HexabitzPlatform/H16R6x/README.md

# H16R6x-Hardware
Hexabitz 8*8 RGB LED Matrix Display Module Hardware Design
