HexabitzPlatform/H16R6x/Released/BOM/H16R6.xlsx

 |  | www.hexabitz.com info@hexabitz.com |  | Bill Of Materials
Customer | Hexabitz | Revision | 0
Project | Hexabitz Modules | Date | 2024-02-10
Board | Matrix LED Display Module (H16R6) | Notes
Designator | Description | Manufacturer Part Number | Manufacturer | Octopart Url | Quantity
R | PCB Header, Unshrouded, Thru 02 Straight Header, .101, AMPMODU Mod II Series | 5-146280-1 | TE Connectivity | https://octopart.com/5-146280-1-te+connectivity+%2F+amp-40259676?r=sp (https://octopart.com/87227-1-te+connectivity-39512052?r=sp) | 1
SWD | Conn Unshrouded Header HDR 3 POS 2.54mm Solder ST Top Entry Thru-Hole Carton | 5-146281-3 | TE Connectivity | https://octopart.com/5-146281-3-te+connectivity+%2F+amp-39745942?r=sp | 1
PWR_IN, PWR_OUT, SERIAL_IN, SERIAL_OUT | 2 Position Total Single Row 2.54 mm Pitch Straight Male Thru-Hole Header | M20-9990245 | HARWIN INC | https://octopart.com/m20-9990245-harwin-7492269?r=sp | 4
C3, C5, C6, C8, C10, C11, C12, C13, C14, C15, C17, C18, C19, C21, C22, C30, C31, C32 | CAP 0402 0,1UF 16V TDK Multilayer Ceramic Capacitors MLCC-SMD/SMT | CGA2B1X7R1C104K050BC | TDK | https://octopart.com/cga2b1x7r1c104k050bc-tdk-26014376?r=sp (https://octopart.com/c0603c104k8ractu-kemet-145075?r=sp&s=9bS9ASSwSEqMCE9KBEQZ0g) | 18
C2 | CAP CER 1UF 10V X5R 0402 | C0402C105K8PAC7411 | KEMET | https://octopart.com/c0402c105k8pac7411-kemet-75146233?r=sp | 1
C7, C4, C9, C16, C20, C23, C24, C25, C26, C27 | Multilayer Ceramic Capacitors MLCC - SMD/SMT 0603 25V 4.7uF X5R 10% T: 0.8mm | C1608X5R1E475K080AC | TDK | https://octopart.com/c1608x5r1e475k080ac-tdk-26013502?r=sp | 10
R2, R4, R5 | RES SMD 0 OHM JUMPER 1/16W 0402 | AC0402JR-070RL | YAGEO | https://octopart.com/ac0402jr-070rl-yageo-21711084?r=sp (https://octopart.com/rc0603jr-070rl-yageo-1241539?r=sp) | 3
R1 | Thick Film Resistors - SMD 0402 1%270ohm | ERJ-PA2F2700X | Panasonic | https://octopart.com/search?q=ERJ-PA2F2700X&currency=USD&specs=0 (https://octopart.com/erj-3geyj271v-panasonic-55560546) | 1
R3 | RES 10K OHM 1% Yageo Thick Film Resistors -SMD 1/16W 0402 | RC0402FR-0710KL | YAGEO | https://octopart.com/rc0402fr-0710kl-yageo-55458461?r=sp (https://octopart.com/search?q=RC0603FR-0710KL&currency=USD&specs=0) | 3
FB1 | Ind chip Bead Multi-Layer 30 ohms 25% 100MHZ Ferrite 1,5A 0603Punched paper T/R | MMZ1608Y300BTA00 | TDK | https://octopart.com/mmz1608y300bta00-tdk-7906990?r=sp | 1
D1 | Red 0603 130° Clear 54 mcd 2 V Surface Mount ChipLED | VLMS1300-GS08 | Vishay (https://octopart.com/manufacturers/wolfspeed) | https://octopart.com/vlms1300-gs08-vishay-21709201?r=sp&s=_gcP4_q8T1SC6PJQPTQ9yA | 1
D2, D3, D4, D5, D6, D7, D8, D9, D10, D11, D12, D13, D14, D15, D16, D17, D18, D19, D20, D21, D22, D23, D24, D25, D26, D27, D28, D29, D30, D31, D32, D33, D34, D35, D36, D37, D38, D39, D40, D41, D42, D43, D44, D45, D46, D47, D48, D49, D50, D51, D52, D53, D54, D55, D56, D57, D58, D59, D60, D61, D62, D63, D64, D65 | SMD LED - RGB APA102-2020 (Pack of 10) | APA102-2020 | SparkFun | https://octopart.com/com-14608-sparkfun-89779982?r=sp | 64
D66 | TVS DIODE 3,3V 10,9V SOD323 | CDSOD323-T03SC | BOURNS INC | https://octopart.com/cdsod323-t03sc-bourns-10487153?r=sp | 1
U1 | MCU 32-Bit ARM Cortex-M0+ RISC 512kByte Flash 1.7V to 3.6V 48-Pin UFQFPN Tray | STM32G0B1CEU6N | STMicroelectronics | https://octopart.com/stm32g0b1ceu6n-stmicroelectronics-116364672?r=sp | 1
IC1 | Voltage Level Translator 2-CH Bidirectional 8-Pin X2-DFN T/R | 74LVC2T45HK3-7 | Diodes Inc. | https://octopart.com/74lvc2t45hk3-7-diodes+inc.-116237008?r=sp | 1
X1 | 8,0000MHZ 33pF SMD MURATA Resonators | CSTNE8M00G550000R0 | Murata | https://octopart.com/cstne8m00g550000r0-murata-91406934?r=sp | 1
