HexabitzPlatform/H16R6x/Design/H16R6.brd

## EAGLE design Design/H16R6.brd (2024-04-26)

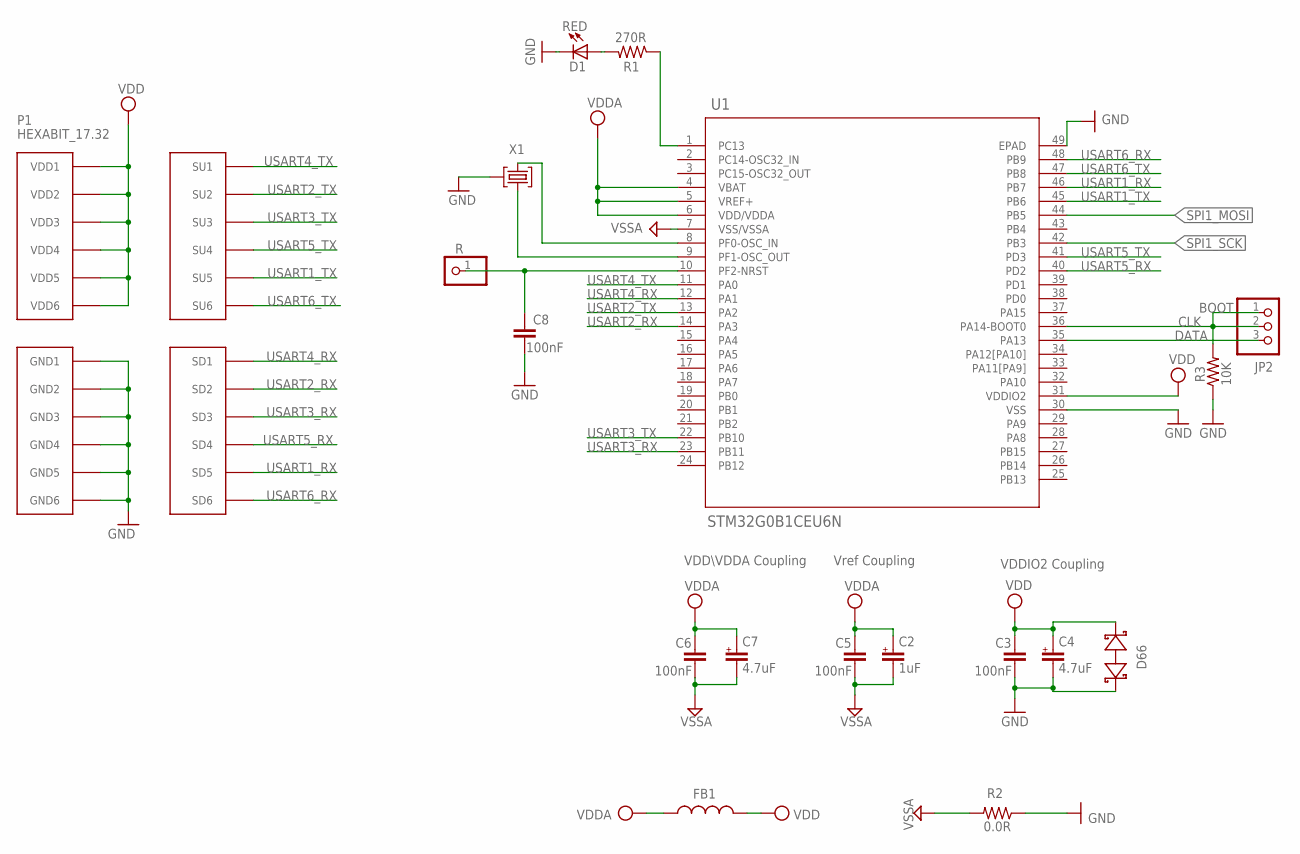
[picture p4: schematic H16R6.sch, sheet 1]

Parts:
C2: 1uF; C-0402-POL
C3, C5, C6, C8: 100nF; C-0402
C4, C7: 4.7uF; C-0402-POL
D1: RED; VLMS1300-GS08; MPN VLMS1300-GS08
D66: BOURNS_CDSOD323-T03SCBOURNS_CDSOD323-T03SC_0_0; BOURNS_CDSOD323-T03SC_0
FB1: FB-TDK_MMZ1608Y300B; MPN MMZ1608Y300B
JP2: PINHD-1X3; 1X03
P1: HEXABIT_17.32
R: R; 1X01
R1: 270R; R-0402
R2: 0.0R; R-0402; MPN RC0603JR-070RL
R3: 10K; R-0402
TRIMBLE-LOGO1: HEXA-LOGO
U1: STM32G0B1CEU6N; HEXABITZ_ICS_QFN_B1CEU6_STM-L
X1: XTALL_CSTCE8M00G52

Connections:
CLK: JP2.1, JP2.2, R3.2, U1.36 (PA14-BOOT0)
DATA: JP2.3, U1.35 (PA13)
GND: C3.2, C4.2, C8.2, D1.C, D66.1 (A), P1.PAD_PD7 (GND1), P1.PAD_PD8 (GND2), P1.PAD_PD9 (GND3), P1.PAD_PD10 (GND4), P1.PAD_PD11 (GND5), P1.PAD_PD12 (GND6), R2.1, R3.1, U1.30 (VSS), U1.49 (EPAD), X1.P$2 (2); also elsewhere on the board
unnamed: D1.A, R1.2
unnamed: C8.1, R.1, U1.10 (PF2-NRST)
unnamed: U1.9 (PF1-OSC_OUT), X1.P$1 (1)
unnamed: U1.8 (PF0-OSC_IN), X1.P$3 (3)
unnamed: R1.1, U1.1 (PC13)
SPI1_MOSI: U1.44 (PB5); also elsewhere on the board
SPI1_SCK: U1.42 (PB3); also elsewhere on the board
USART1_RX: P1.PAD_PD5 (SD5), U1.46 (PB7)
USART1_TX: P1.PAD_PU5 (SU5), U1.45 (PB6)
USART2_RX: P1.PAD_PD2 (SD2), U1.14 (PA3)
USART2_TX: P1.PAD_PU2 (SU2), U1.13 (PA2)
USART3_RX: P1.PAD_PD3 (SD3), U1.23 (PB11)
USART3_TX: P1.PAD_PU3 (SU3), U1.22 (PB10)
USART4_RX: P1.PAD_PD1 (SD1), U1.12 (PA1)
USART4_TX: P1.PAD_PU1 (SU1), U1.11 (PA0)
USART5_RX: P1.PAD_PD4 (SD4), U1.40 (PD2)
USART5_TX: P1.PAD_PU4 (SU4), U1.41 (PD3)
USART6_RX: P1.PAD_PD6 (SD6), U1.48 (PB9)
USART6_TX: P1.PAD_PU6 (SU6), U1.47 (PB8)
VDD: C3.1, C4.1, D66.2 (C), FB1.2, P1.PAD_PU7 (VDD1), P1.PAD_PU8 (VDD2), P1.PAD_PU9 (VDD3), P1.PAD_PU10 (VDD4), P1.PAD_PU11 (VDD5), P1.PAD_PU12 (VDD6), U1.31 (VDDIO2); also elsewhere on the board
VDDA: C2.1, C5.1, C6.1, C7.1, FB1.1, U1.4 (VBAT), U1.5 (VREF+), U1.6 (VDD/VDDA)
VSSA: C2.2, C5.2, C6.2, C7.2, R2.2, U1.7 (VSS/VSSA)

Notes on the sheet:
Vref Coupling
VDDIO2 Coupling
VDD\VDDA Coupling
BOOT

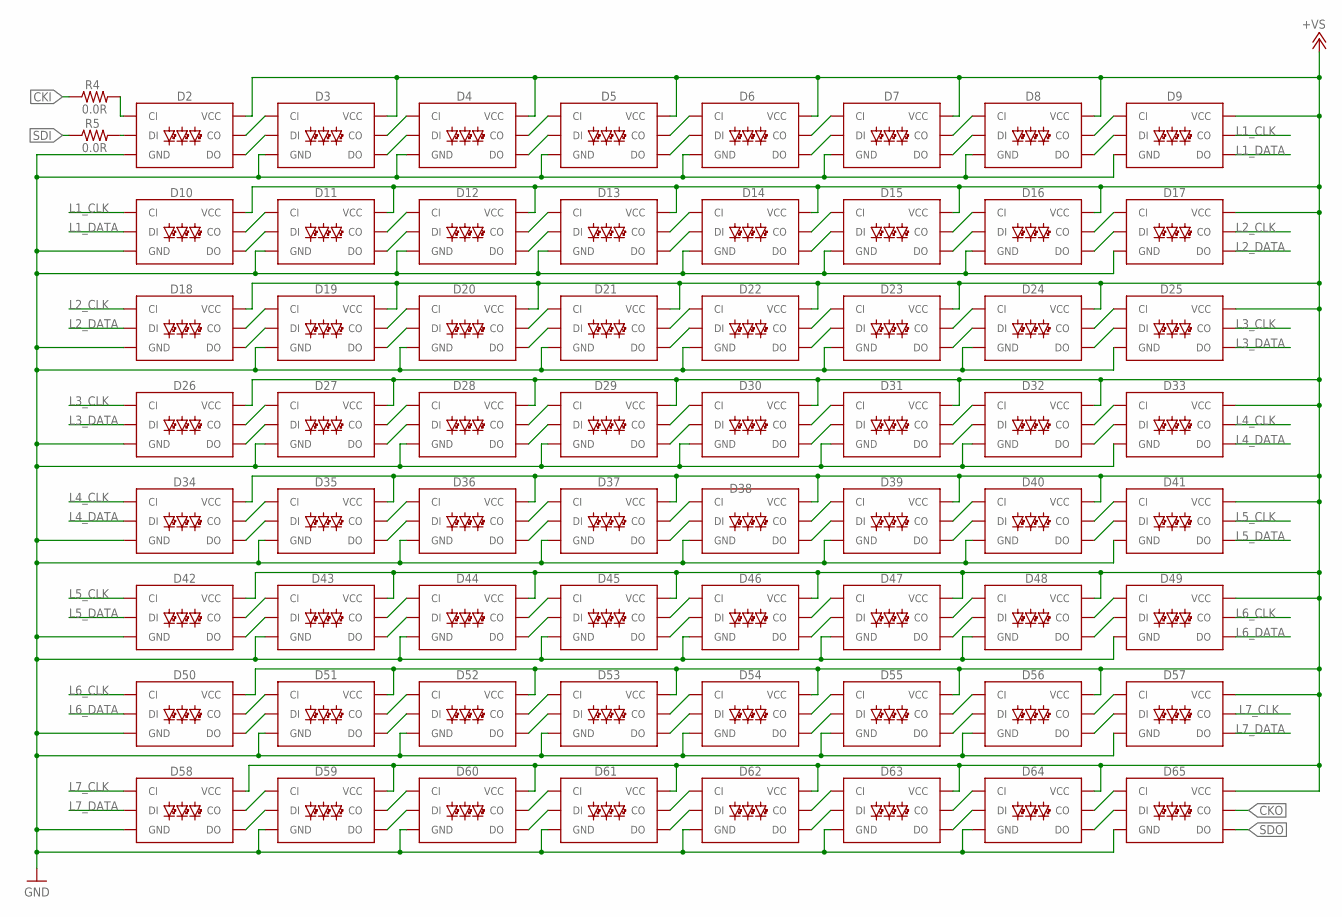
[picture p5: schematic H16R6.sch, sheet 2]

Parts:
D2, D3, D4, D5, D6, D7, D8, D9, D10, D11, D12, D13, D14, D15, D16, D17, D18, D19, D20, D21, D22, D23, D24, D25, D26, D27, D28, D29, D30, D31, D32, D33, D34, D35, D36, D37, D38, D39, D40, D41, D42, D43, D44, D45, D46, D47, D48, D49, D50, D51, D52, D53, D54, D55, D56, D57, D58, D59, D60, D61, D62, D63, D64, D65: SPARKFUN-LED_APA102-2020
R4, R5: 0.0R; R-0402

Connections:
+VS: D2.VDD (VCC), D2.VDD1 (VCC), D3.VDD (VCC), D3.VDD1 (VCC), D4.VDD (VCC), D4.VDD1 (VCC), D5.VDD (VCC), D5.VDD1 (VCC), D6.VDD (VCC), D6.VDD1 (VCC), D7.VDD (VCC), D7.VDD1 (VCC), D8.VDD (VCC), D8.VDD1 (VCC), D9.VDD (VCC), D9.VDD1 (VCC), D10.VDD (VCC), D10.VDD1 (VCC), D11.VDD (VCC), D11.VDD1 (VCC), D12.VDD (VCC), D12.VDD1 (VCC), D13.VDD (VCC), D13.VDD1 (VCC), D14.VDD (VCC), D14.VDD1 (VCC), D15.VDD (VCC), D15.VDD1 (VCC), D16.VDD (VCC), D16.VDD1 (VCC), D17.VDD (VCC), D17.VDD1 (VCC), D18.VDD (VCC), D18.VDD1 (VCC), D19.VDD (VCC), D19.VDD1 (VCC), D20.VDD (VCC), D20.VDD1 (VCC), D21.VDD (VCC), D21.VDD1 (VCC), D22.VDD (VCC), D22.VDD1 (VCC), D23.VDD (VCC), D23.VDD1 (VCC), D24.VDD (VCC), D24.VDD1 (VCC), D25.VDD (VCC), D25.VDD1 (VCC), D26.VDD (VCC), D26.VDD1 (VCC), D27.VDD (VCC), D27.VDD1 (VCC), D28.VDD (VCC), D28.VDD1 (VCC), D29.VDD (VCC), D29.VDD1 (VCC), D30.VDD (VCC), D30.VDD1 (VCC), D31.VDD (VCC), D31.VDD1 (VCC), D32.VDD (VCC), D32.VDD1 (VCC), D33.VDD (VCC), D33.VDD1 (VCC), D34.VDD (VCC), D34.VDD1 (VCC), D35.VDD (VCC), D35.VDD1 (VCC), D36.VDD (VCC), D36.VDD1 (VCC), D37.VDD (VCC), D37.VDD1 (VCC), D38.VDD (VCC), D38.VDD1 (VCC), D39.VDD (VCC), D39.VDD1 (VCC), D40.VDD (VCC), D40.VDD1 (VCC), D41.VDD (VCC), D41.VDD1 (VCC), D42.VDD (VCC), D42.VDD1 (VCC), D43.VDD (VCC), D43.VDD1 (VCC), D44.VDD (VCC), D44.VDD1 (VCC), D45.VDD (VCC), D45.VDD1 (VCC), D46.VDD (VCC), D46.VDD1 (VCC), D47.VDD (VCC), D47.VDD1 (VCC), D48.VDD (VCC), D48.VDD1 (VCC), D49.VDD (VCC), D49.VDD1 (VCC), D50.VDD (VCC), D50.VDD1 (VCC), D51.VDD (VCC), D51.VDD1 (VCC), D52.VDD (VCC), D52.VDD1 (VCC), D53.VDD (VCC), D53.VDD1 (VCC), D54.VDD (VCC), D54.VDD1 (VCC), D55.VDD (VCC), D55.VDD1 (VCC), D56.VDD (VCC), D56.VDD1 (VCC), D57.VDD (VCC), D57.VDD1 (VCC), D58.VDD (VCC), D58.VDD1 (VCC), D59.VDD (VCC), D59.VDD1 (VCC), D60.VDD (VCC), D60.VDD1 (VCC), D61.VDD (VCC), D61.VDD1 (VCC), D62.VDD (VCC), D62.VDD1 (VCC), D63.VDD (VCC), D63.VDD1 (VCC), D64.VDD (VCC), D64.VDD1 (VCC), D65.VDD (VCC), D65.VDD1 (VCC); also elsewhere on the board
CKI: R4.1; also elsewhere on the board
CKO: D65.CO; also elsewhere on the board
GND: D2.GND, D3.GND, D4.GND, D5.GND, D6.GND, D7.GND, D8.GND, D9.GND, D10.GND, D11.GND, D12.GND, D13.GND, D14.GND, D15.GND, D16.GND, D17.GND, D18.GND, D19.GND, D20.GND, D21.GND, D22.GND, D23.GND, D24.GND, D25.GND, D26.GND, D27.GND, D28.GND, D29.GND, D30.GND, D31.GND, D32.GND, D33.GND, D34.GND, D35.GND, D36.GND, D37.GND, D38.GND, D39.GND, D40.GND, D41.GND, D42.GND, D43.GND, D44.GND, D45.GND, D46.GND, D47.GND, D48.GND, D49.GND, D50.GND, D51.GND, D52.GND, D53.GND, D54.GND, D55.GND, D56.GND, D57.GND, D58.GND, D59.GND, D60.GND, D61.GND, D62.GND, D63.GND, D64.GND, D65.GND; also elsewhere on the board
L1_CLK: D9.CO, D10.CI
L1_DATA: D9.DO, D10.DI
L2_CLK: D17.CO, D18.CI
L2_DATA: D17.DO, D18.DI
L3_CLK: D25.CO, D26.CI
L3_DATA: D25.DO, D26.DI
L4_CLK: D33.CO, D34.CI
L4_DATA: D33.DO, D34.DI
L5_CLK: D41.CO, D42.CI
L5_DATA: D41.DO, D42.DI
L6_CLK: D49.CO, D50.CI
L6_DATA: D49.DO, D50.DI
L7_CLK: D57.CO, D58.CI
L7_DATA: D57.DO, D58.DI
unnamed: D3.DO, D4.DI
unnamed: D3.CO, D4.CI
unnamed: D2.DO, D3.DI
unnamed: D2.CO, D3.CI
unnamed: D8.DO, D9.DI
unnamed: D8.CO, D9.CI
unnamed: D7.CO, D8.CI
unnamed: D7.DO, D8.DI
unnamed: D5.CO, D6.CI
unnamed: D5.DO, D6.DI
unnamed: D16.CO, D17.CI
unnamed: D16.DO, D17.DI
unnamed: D10.CO, D11.CI
unnamed: D10.DO, D11.DI
unnamed: D11.CO, D12.CI
unnamed: D11.DO, D12.DI
unnamed: D12.CO, D13.CI
unnamed: D18.CO, D19.CI
unnamed: D18.DO, D19.DI
unnamed: D19.CO, D20.CI
unnamed: D19.DO, D20.DI
unnamed: D20.CO, D21.CI
unnamed: D20.DO, D21.DI
unnamed: D21.CO, D22.CI
unnamed: D21.DO, D22.DI
unnamed: D22.CO, D23.CI
unnamed: D22.DO, D23.DI
unnamed: D23.CO, D24.CI
unnamed: D23.DO, D24.DI
unnamed: D24.CO, D25.CI
unnamed: D24.DO, D25.DI
unnamed: D26.CO, D27.CI
unnamed: D26.DO, D27.DI
unnamed: D27.CO, D28.CI
unnamed: D27.DO, D28.DI
unnamed: D28.CO, D29.CI
unnamed: D28.DO, D29.DI
unnamed: D29.CO, D30.CI
unnamed: D29.DO, D30.DI
unnamed: D31.CO, D32.CI
unnamed: D31.DO, D32.DI
unnamed: D30.CO, D31.CI
unnamed: D30.DO, D31.DI
unnamed: D32.CO, D33.CI
unnamed: D32.DO, D33.DI
unnamed: D34.CO, D35.CI
unnamed: D34.DO, D35.DI
unnamed: D35.CO, D36.CI
unnamed: D35.DO, D36.DI
unnamed: D36.CO, D37.CI
unnamed: D36.DO, D37.DI
unnamed: D37.CO, D38.CI
unnamed: D37.DO, D38.DI
unnamed: D38.CO, D39.CI
unnamed: D38.DO, D39.DI
unnamed: D40.CO, D41.CI
unnamed: D40.DO, D41.DI
unnamed: D39.CO, D40.CI
unnamed: D39.DO, D40.DI
unnamed: D48.CO, D49.CI
unnamed: D48.DO, D49.DI
unnamed: D56.CO, D57.CI
unnamed: D56.DO, D57.DI
unnamed: D64.CO, D65.CI
unnamed: D64.DO, D65.DI
unnamed: D55.DO, D56.DI
unnamed: D55.CO, D56.CI
unnamed: D63.CO, D64.CI
unnamed: D63.DO, D64.DI
unnamed: D54.CO, D55.CI
unnamed: D54.DO, D55.DI
unnamed: D62.CO, D63.CI
unnamed: D62.DO, D63.DI
unnamed: D61.DO, D62.DI
unnamed: D61.CO, D62.CI
unnamed: D60.CO, D61.CI
unnamed: D60.DO, D61.DI
unnamed: D59.CO, D60.CI
unnamed: D59.DO, D60.DI
unnamed: D58.DO, D59.DI
unnamed: D58.CO, D59.CI
unnamed: D53.DO, D54.DI
unnamed: D53.CO, D54.CI
unnamed: D51.CO, D52.CI
unnamed: D51.DO, D52.DI
unnamed: D52.DO, D53.DI
unnamed: D52.CO, D53.CI
unnamed: D50.DO, D51.DI
unnamed: D50.CO, D51.CI
unnamed: D42.CO, D43.CI
unnamed: D42.DO, D43.DI
unnamed: D43.CO, D44.CI
unnamed: D43.DO, D44.DI
unnamed: D44.CO, D45.CI
unnamed: D44.DO, D45.DI
unnamed: D45.DO, D46.DI
unnamed: D45.CO, D46.CI
unnamed: D46.CO, D47.CI
unnamed: D46.DO, D47.DI
unnamed: D47.CO, D48.CI
unnamed: D47.DO, D48.DI
unnamed: D12.DO, D13.DI
unnamed: D13.DO, D14.DI
unnamed: D13.CO, D14.CI
unnamed: D14.CO, D15.CI
unnamed: D14.DO, D15.DI
unnamed: D15.CO, D16.CI
unnamed: D15.DO, D16.DI
unnamed: D4.CO, D5.CI
unnamed: D4.DO, D5.DI
unnamed: D6.CO, D7.CI
unnamed: D6.DO, D7.DI
unnamed: D2.DI, R5.2
unnamed: D2.CI, R4.2
SDI: R5.1; also elsewhere on the board
SDO: D65.DO; also elsewhere on the board

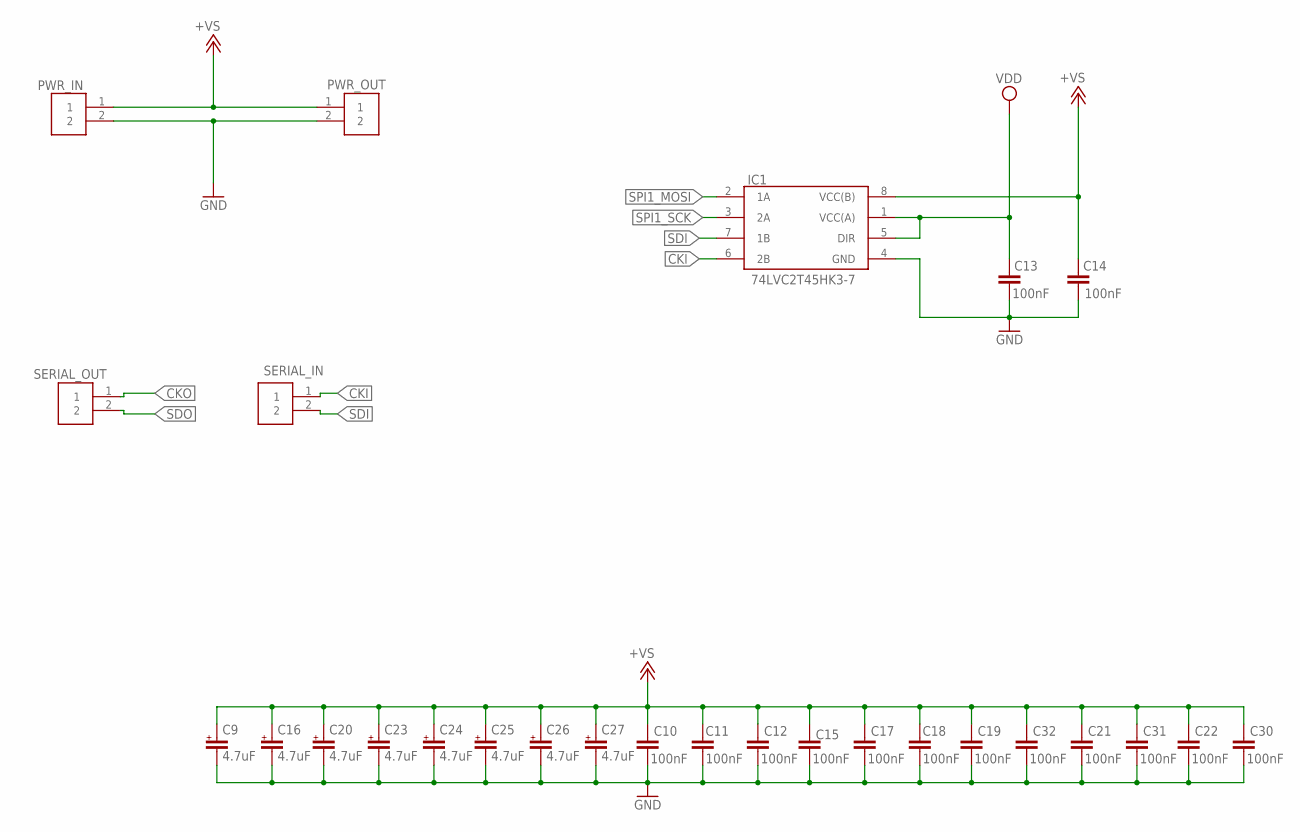
[picture p6: schematic H16R6.sch, sheet 3]

Parts:
C9, C16, C20, C23, C24, C25, C26, C27: 4.7uF; C-0402-POL
C10, C11, C12, C13, C14, C15, C17, C18, C19, C21, C22, C30, C31, C32: 100nF; C-0402
IC1: 74LVC2T45HK3-7; 74LVC2T45HK37
PWR_IN: 3-644456-2; TE_3-644456-2
PWR_OUT: 3-644456-2; TE_3-644456-2
SERIAL_IN: 3-644456-2; TE_3-644456-2
SERIAL_OUT: 3-644456-2; TE_3-644456-2

Connections:
+VS: C9.1, C10.1, C11.1, C12.1, C14.1, C15.1, C16.1, C17.1, C18.1, C19.1, C20.1, C21.1, C22.1, C23.1, C24.1, C25.1, C26.1, C27.1, C30.1, C31.1, C32.1, IC1.8 (VCC(B)), PWR_IN.1, PWR_OUT.1; also elsewhere on the board
CKI: IC1.6 (2B), SERIAL_IN.1; also elsewhere on the board
CKO: SERIAL_OUT.1; also elsewhere on the board
GND: C9.2, C10.2, C11.2, C12.2, C13.2, C14.2, C15.2, C16.2, C17.2, C18.2, C19.2, C20.2, C21.2, C22.2, C23.2, C24.2, C25.2, C26.2, C27.2, C30.2, C31.2, C32.2, IC1.4 (GND), PWR_IN.2, PWR_OUT.2; also elsewhere on the board
SDI: IC1.7 (1B), SERIAL_IN.2; also elsewhere on the board
SDO: SERIAL_OUT.2; also elsewhere on the board
SPI1_MOSI: IC1.2 (1A); also elsewhere on the board
SPI1_SCK: IC1.3 (2A); also elsewhere on the board
VDD: C13.1, IC1.1 (VCC(A)), IC1.5 (DIR); also elsewhere on the board

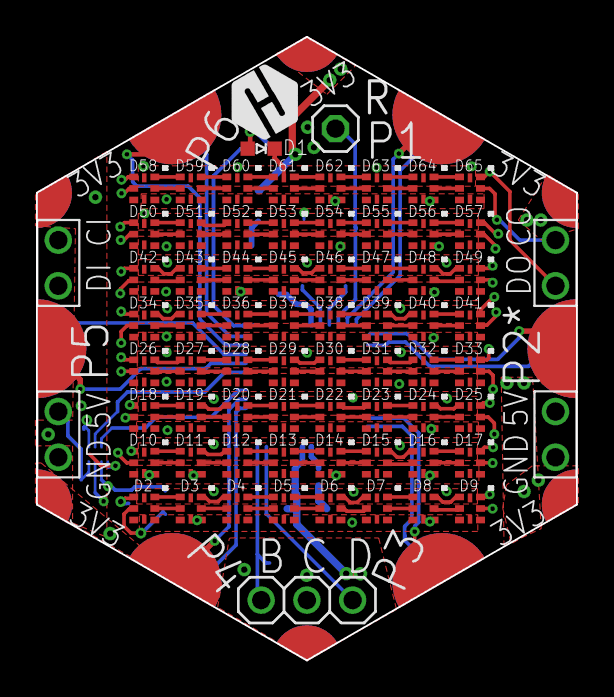
[picture p7: board H16R6.brd from above]

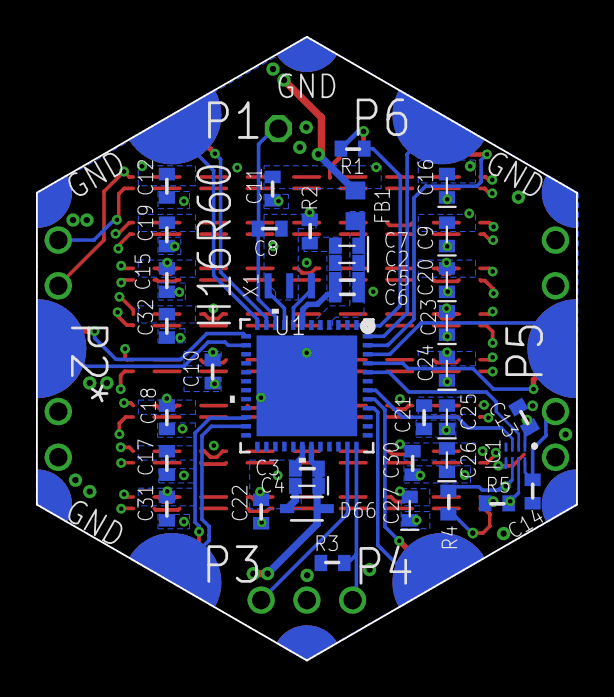
[picture p8: board H16R6.brd from below]

Board: 4 copper layers, 30.0 x 34.6 mm, 112 parts (39 on the bottom side), 158 nets.
