HexabitzPlatform/H16R6x/(commit log)

2024-02-10 Reviewed Version, all finished.
    [H16R6.brd, H16R6.sch, H16R6.xlsx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]
2024-02-24 -Fix the LEDs quantity in the BOM
    [H16R6.xlsx]
2024-04-12 Edit the logo Add the TVS diode
    [H16R6.brd, H16R6.sch, H16R6.xlsx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]
2024-04-17 Replace the led APA-102-2020-6 with APA-102-2020-8
    [H16R6.brd, H16R6.sch, H16R6.xlsx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]
2024-04-26 Fix the clearance and soldermask issues Replace the 0603 4.7uF tant cap with ceramic cap in the BOM
    [H16R6.brd, H16R6.sch, H16R6.xlsx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]
2024-04-29 Fix BOM
    [H16R6.xlsx]
